kyleservicetech/BattIR-meter/Photo#5.JPG

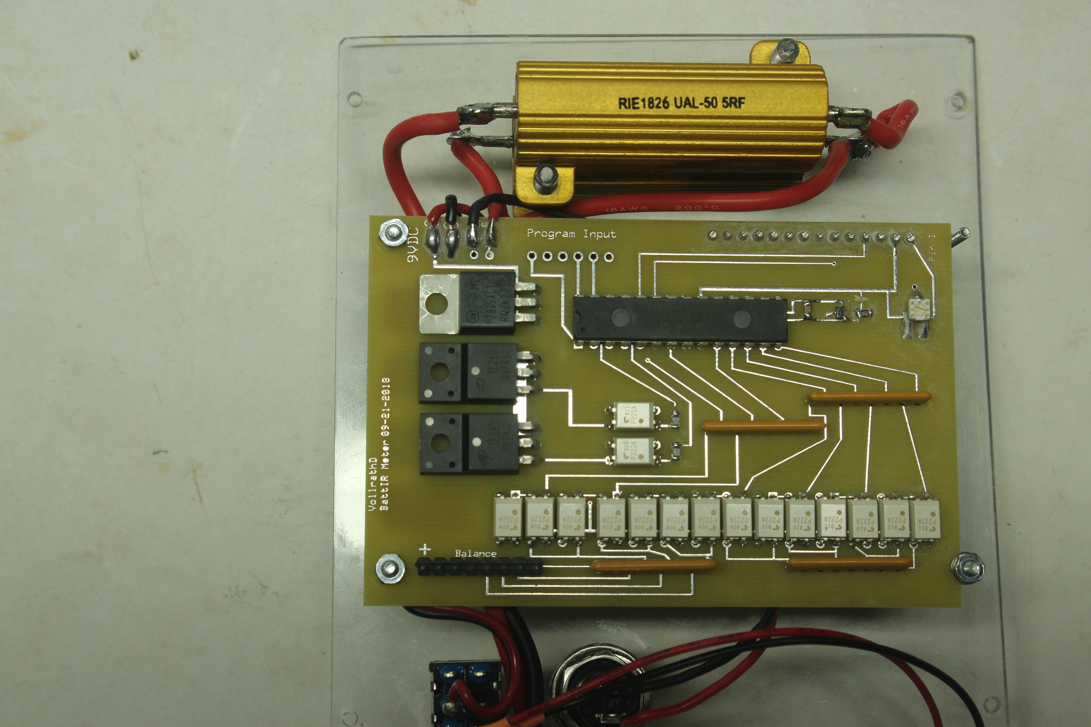
Photo#5.JPG
