kyleservicetech/BattIR-meter/Photo#1.JPG

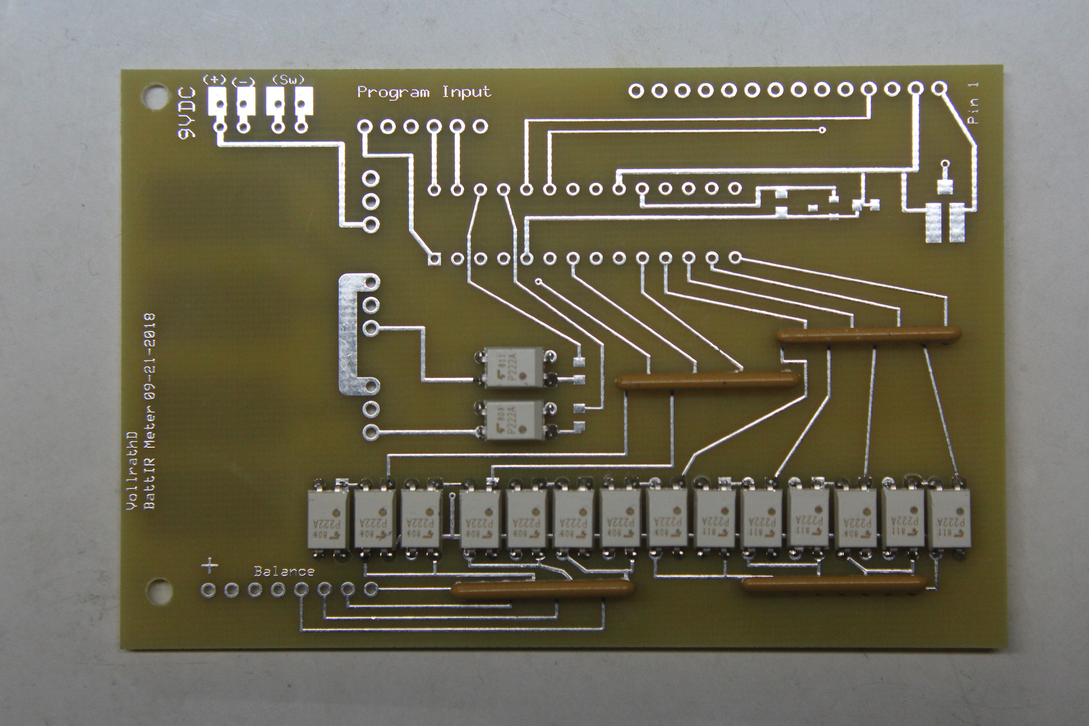
Photo#1.JPG
