kyleservicetech/BattIR-meter/README.md

# BattIR-meter
This project design allows measuring the internal resistance of each cell in a LiPo, Life, or A123 battery pack.

The parts can be ordered from Digikey.com with the following link

http://www.digikey.com/short/p3c1f5
