kyleservicetech/BattIR-meter/BattIR Meter Project PDF File.pdf

## The BattIR Project with USB connection to IBM PC

Since the author has no control over the quality or skill level of the persons building up this project, there needs to be the following disclaimer.

The software is provided “As Is” with the author not being responsible for any claim, damages or similar issues on the use of this project.

An added feature is the addition of BattIR software to allow downloading all test results through an Arduino Nano’s USB port directly to an IBM PC through its USB port, using a standard USB cable. The Arduino Nano plugs into the existing BattIR microcontroller programming pins, no PCB change required.

HOW IT WORKS

The BattIR project uses 14 electronic relays to connect each battery cell in succession to the same Pic-Chip A/D input. This way there is no variation in the PicChip between different A/D inputs since only one PicChip channel is used.

So far, 41 BattIR meters have been built, all work very well. (I did miss a solder joint on one meter)

A precision 0.2% Voltage reference, part U2 has been added to the original design in order to improve basic DC voltage accuracy, as compared to the original BattIR meters.

In addition, each cell voltage is read 10 times, and an average is taken of those voltage readings. .

The multiple cell voltage readings eliminates voltage "jitter" on the last digit of the four digit display of the battery voltage. Tests on the three prototypes shows that the voltage read out is accurate to around 0.3% on voltages between 2.5 VDC and 4.5 VDC as compared to my Fluke 87V meter while using its Hi Res feature. These units should hold plus/ minus 1% on the measured cell voltages.

The BattIR meter first connects a 5 Ohm 1% resistor across the battery pack, then reads and saves the individual cell voltage readings to the first table. Next, it connects a 2.00 Ohm 1% resistor to the battery pack, and reads and saves the individual voltage readings to a second table.

Last, the BattIR meter applies both the 5.00 and 2.00 Ohm resistors in parallel to the battery pack, and again reads and saves the voltage readings to a third table.

The individual cell IR calculation is:

IR = (Volts Low Amps- Volts Hi Amps)

Divided by (High Amps - Low Amps)

The first and third voltage readings are used to calculate the individual cell IR values and displays them to the LCD display.

Example, a cell measuring 3.71 Volts at 4.45 Amps and measuring 3.58 Volts at 15.1 Amps would have a cell resistance of 12.2 MilliOhms. This meter has a maximum of 999 MilliOhms range.

The software also has commands to preset the batteries Mah rating and uses the Mah rating to calculate the maximum safe current for the battery.

Credit must be given to Forsyth, Julian, and Giles for their work in testing countless LiPo batteries, and coming up with the formula that is used to calculate the maximum safe current for the given LiPo or LiFe/ A123 battery pack. These names are included on the BattIR LCD display.

Last but not least, the test currents that are applied to the battery pack are derived by the batteries voltage divided by the resistance of the power resistors.

If the 1% 5 ohm and 2 ohm power resistors are not available, 5% units can be substituted with a slight loss of IR accuracy.

One feature of this setup is that the 5, 6 or 7 cell packs will pull higher test currents through the power resistors, compared to much lower test currents that occur with the 1, 2 or 3 cell LiPo packs.

As a result, those usually smaller 2 cell 200 Mah battery packs are tested at current levels of around 5 Amps, compared to the test current of around 15 Amps for the higher voltage big battery packs.

This meter also has the capability of displaying the individual cell voltage of the battery pack on each of the load currents applied to the pack. It can also display all cell voltages while connected to an ESC and motor under full power as an example.

## Time to start the project!

(Equipment Needed)

This project uses a number of surface mounted resistors in its design. Surface mounted resistors might be a bit scary for someone that has not worked with them. But, with a bit of practice, assembly of a project like this goes much faster than through hole resistors.

Note the required equipment in the photo at right that will be used to build up the circuit board. An old cookie sheet will aid in finding
any | surface | mounted | parts | accidentally
dropped. For older folks, a magnifying visor helps a lot. Then a needle pointed soldering iron is used along with tweezers to place and solder the components. I use 0.040 sized rosin cored solder for these type projects.

What I’ve learned over the years, is to place a

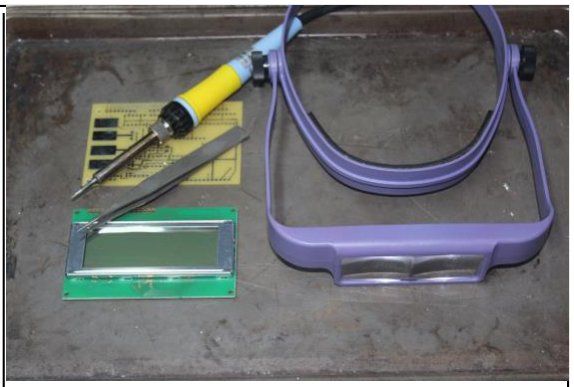
[picture p3: figure]

tiny bit of solder on ONE of the pads of the resistor as an example.

Then, place the iron on that bit of solder, and, using the tweezers, “slide” the surface mounted resistor into that tiny bit of solder. Wait for the solder to cool off, then solder the other end of the resistor. This takes longer to describe than actually doing it.

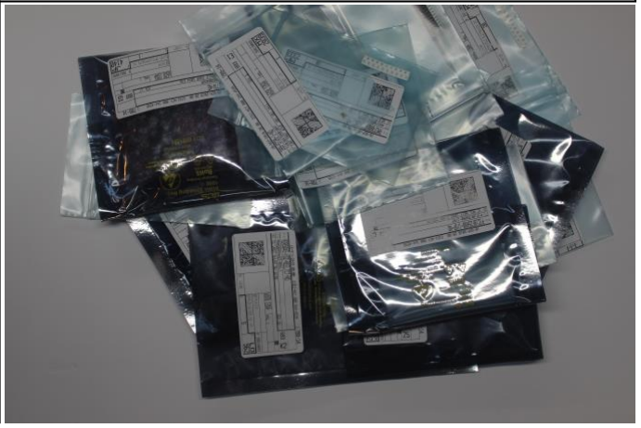
[picture p4: figure]
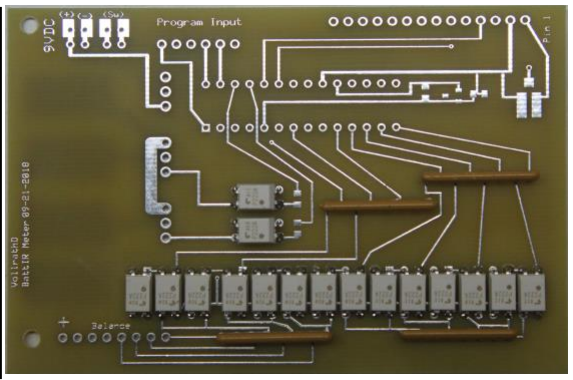
[picture p5: figure]

## Install the electronic relays

Next, insert each of the 16 electronic relays into the circuit board. Be careful to not have any of the relay pins bent under the relay, rather than going into their respective holes. Also, pay attention to the small dot on these relays showing which is pin #1. Next, install and solder up the resistor networks that are used with the electronic relays.

At the right is the components as received from www.digikey.com. All components are placed in individual bags, properly marked with component type and value.

Order extra resistors and capacitors. Most 10 parts for under 50 cents.

These correspond with the parts list
that | is | part | of | the
www.expresspcb.com schematic that is included along with the PCB layout that can be downloaded from github.

## Install The Microcontroller

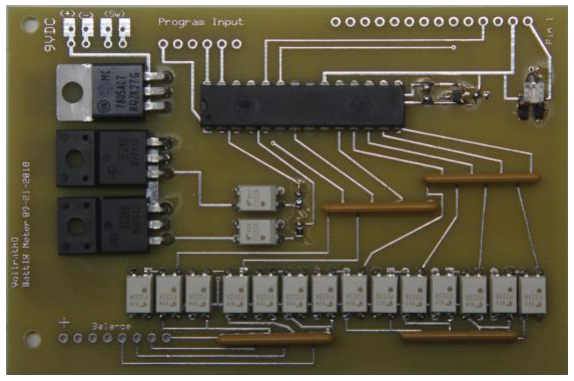
[picture p6: figure]

Here we install the microcontroller, along with the 5 Volt regulator that powers the project, along with the two MosFets that are used to connect the battery under test to the load resistors.

Be very careful not to fold any of the microcontroller pins under the chip. If this happens it will be difficult to fix after the chip is soldered. Again, be aware of the location of the dot on the microcontroller, it should be located to the bottom left on the photo. (The PCB Pin#1 hole is square, the remaining pin holes are round.)

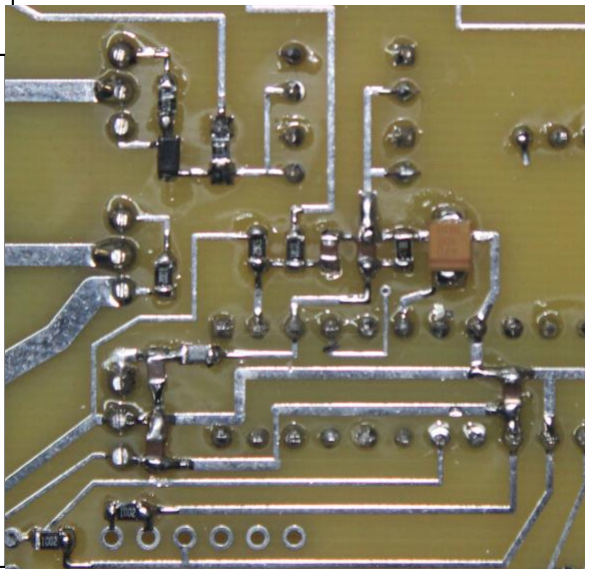
[picture p7: figure]

## Install the surface mounted parts on the back of the PCB

Time to install the parts on the back of the PCB, paying particular attention to the part number, part value, and location on the PCB.

For those interested in this project, the author will make available a limited supply of the circuit board plus the programmed microcontroller for 20% over cost of the two items, plus shipping cost, USA only.

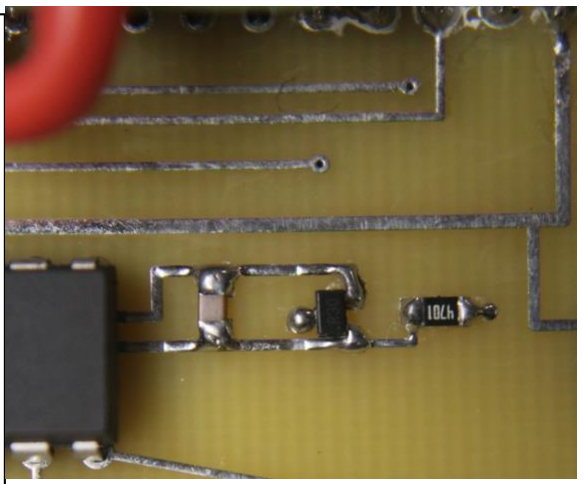
[picture p8: figure]

## Install the 0.2% voltage reference

with its associated resistor and capacitor. Next, install the potentiometer that is used to set the LCD display Contrast.

Note the very tiny size of this voltage reference. Here is the time where it would be wise to do the assembly of the BattIR PCB on top of an old cookie sheet or similar in case the reference chip is dropped.

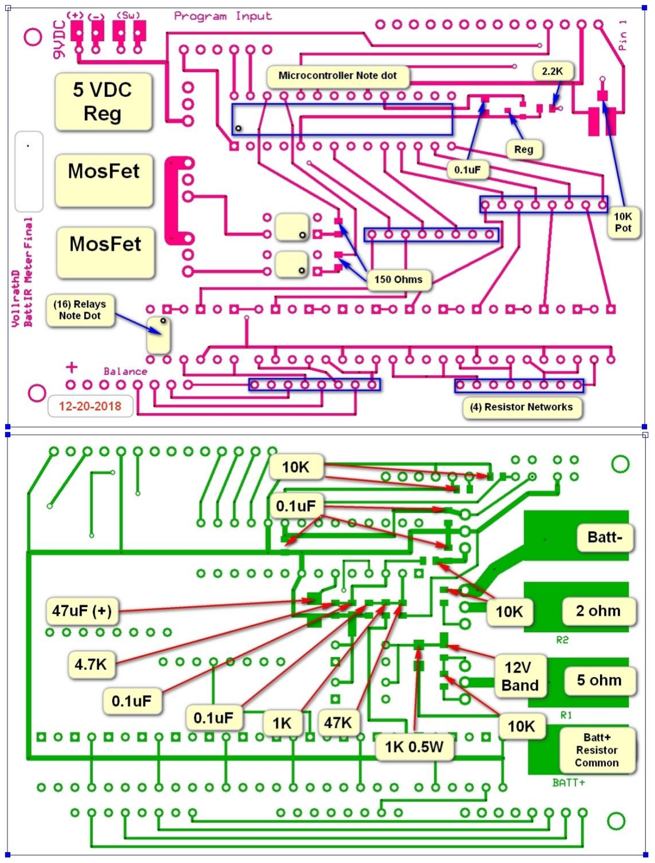
[picture p9: page 4]

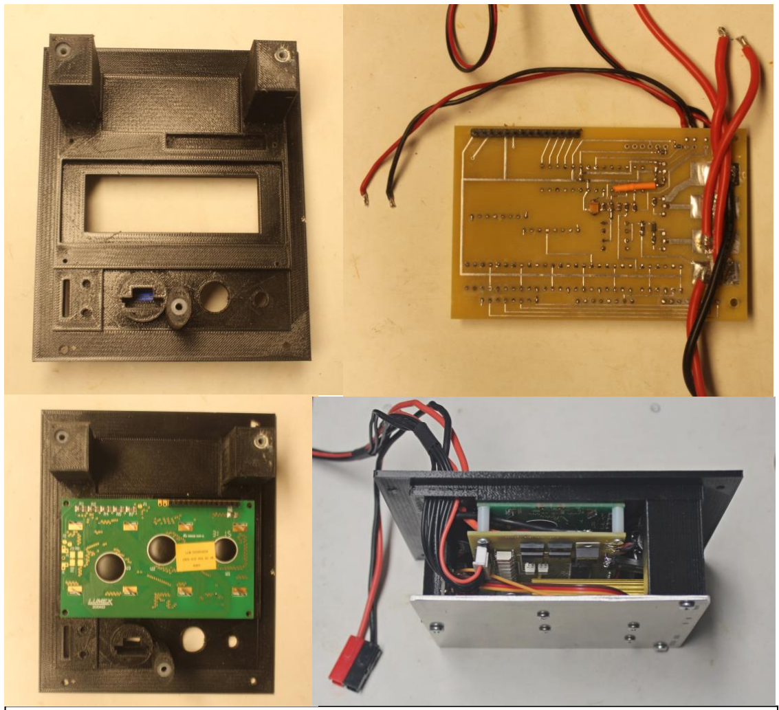
[picture p10: figure]

The final project as installed on a 3D Printed panel. The PCB is mounted along with the LCD with some #3 screws drilled into the 3D cutout for the display.

Underneath the PCB are the wire connections to the two power resistors. Since the 3D PLA filament doesn’t work well with heat from those power resistors, the resistors were mounted to an aluminum sheet. Thick CA is very effective in gluing items to the 3D printed panels. Also shown is the Arduino Nano that provides the interface between the BattIR meter and the IBM PC computer USB port.

When first powered up, the LCD display will be blank. The top right potentiometer must be turned counter clockwise until the LCD display properly displays the information.

The TinkerCad 3D drawing files show this version of the front panel along with the ventilated case shown on the next page. Larger ventilation slots were provided to lower the risk of heat from the power resistors from affecting the PLA filament used to build the 3D enclosures.

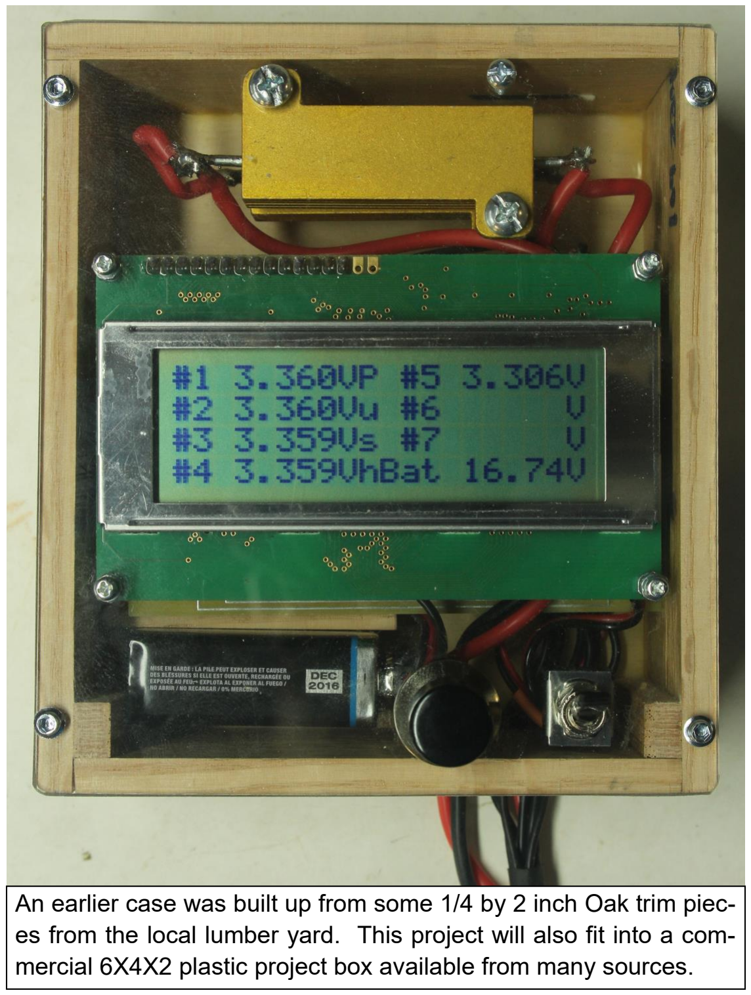
[picture p11: page 6]

## An earlier case was built up from some 1/4 by 2 inch Oak trim pieces from the local lumber yard. This project will also fit into a com-

mercial 6X4X2 plastic project box available from many sources.

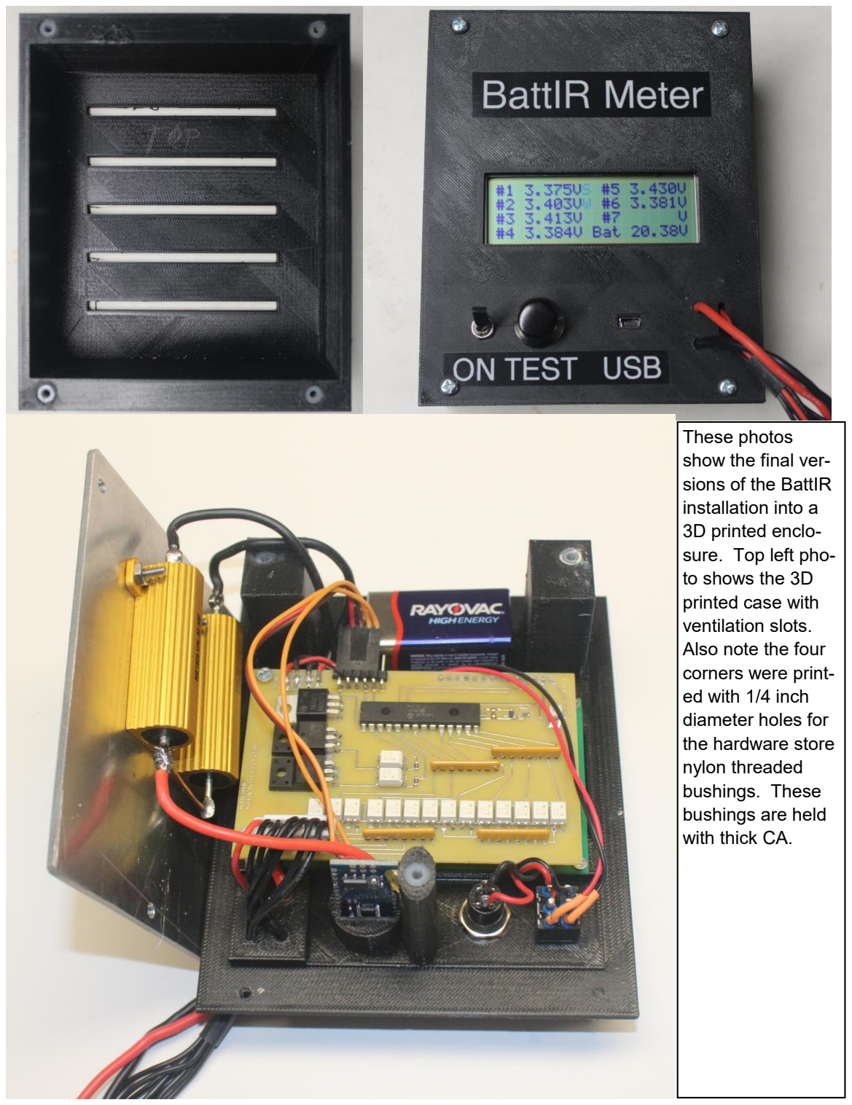
[picture p12: page 7]

These photos
show the final versions of the BattIR
installation into a
3D printed enclosure. Top left photo shows the 3D
printed case with
ventilation slots.
Also note the four
corners were printed with 1/4 inch
diameter holes for
the hardware store
nylon threaded
bushings. These
bushings are held
with thick CA.
