kyleservicetech/BattIR-meter/Gerber Text.jpg

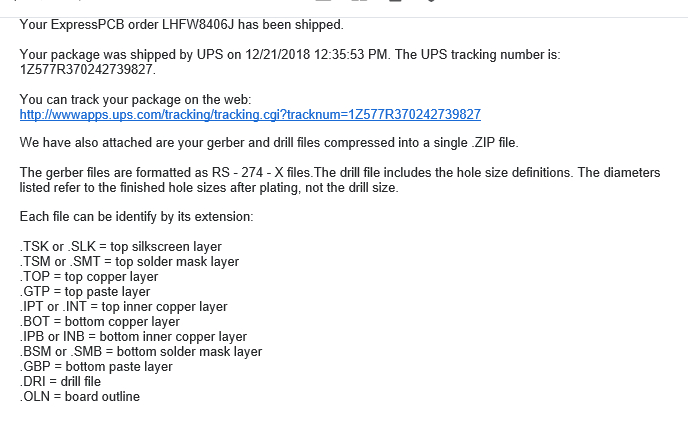
Gerber Text.jpg
