kyleservicetech/BattIR-meter/Interconnection SchematicVrI.jpg

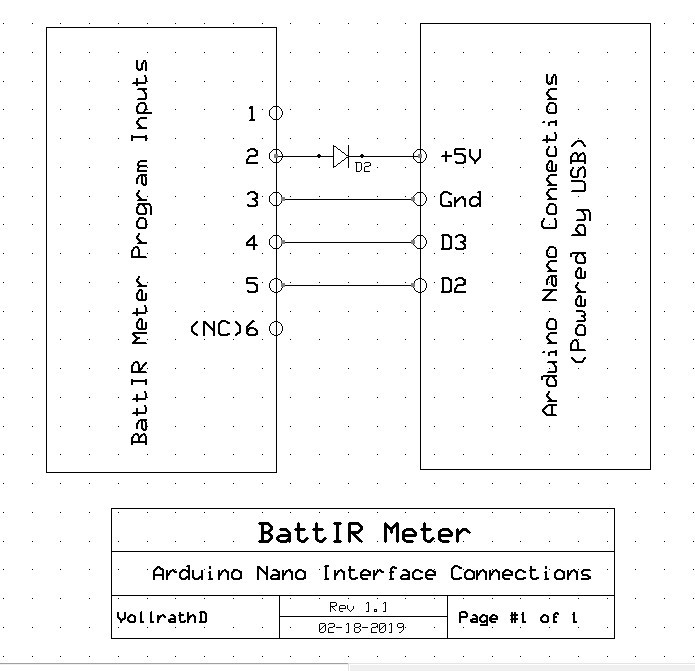
Interconnection SchematicVrI.jpg
