kyleservicetech/BattIR-meter/Photo#2.JPG

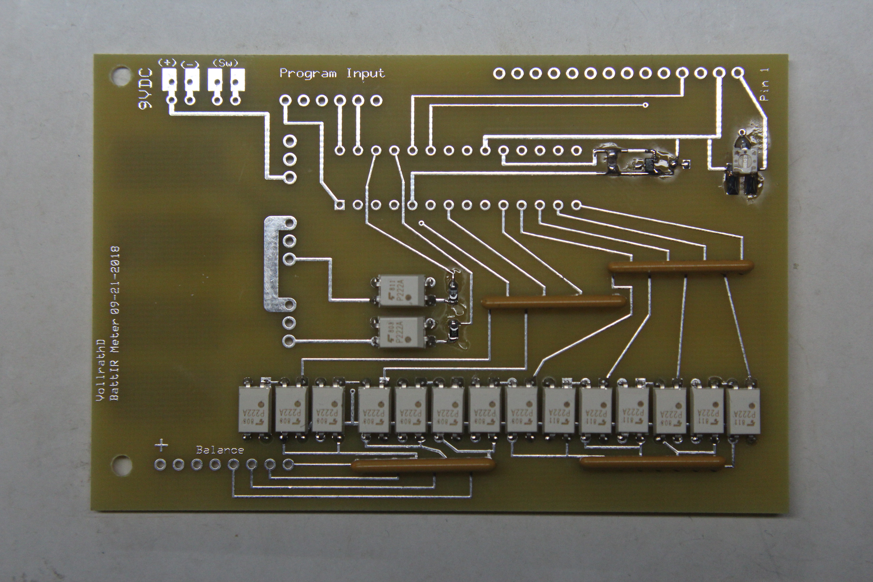
Photo#2.JPG
