kyleservicetech/BattIR-meter/Photo#3.JPG

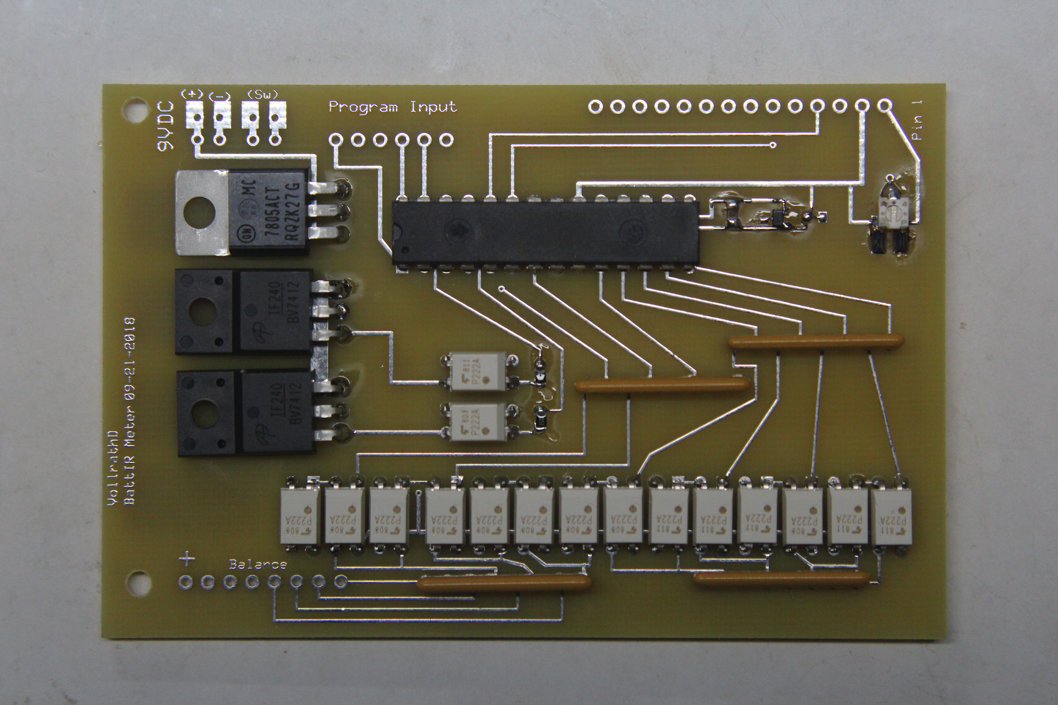
Photo#3.JPG
