kyleservicetech/BattIR-meter/Photo#4.JPG

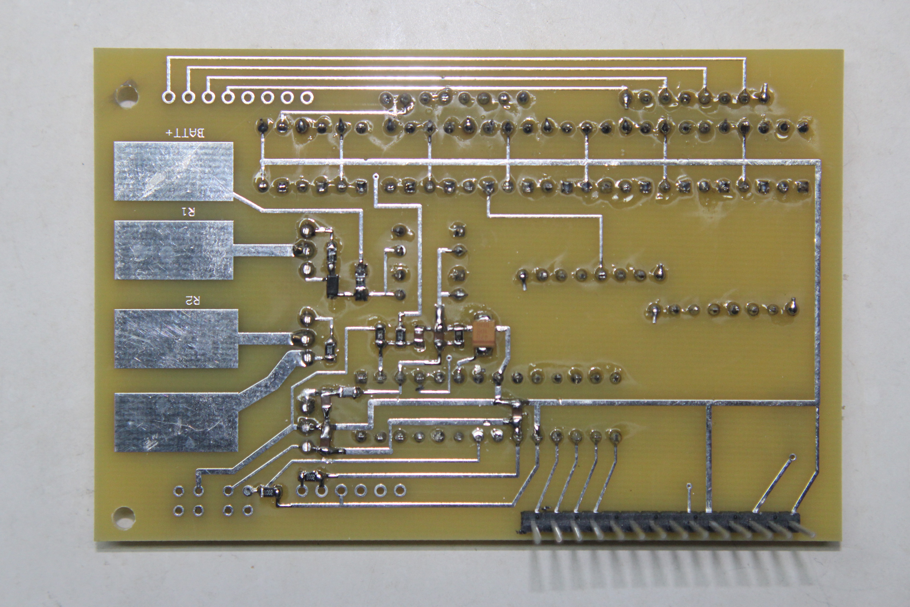
Photo#4.JPG
