kyleservicetech/BattIR-meter/Photo#6.JPG

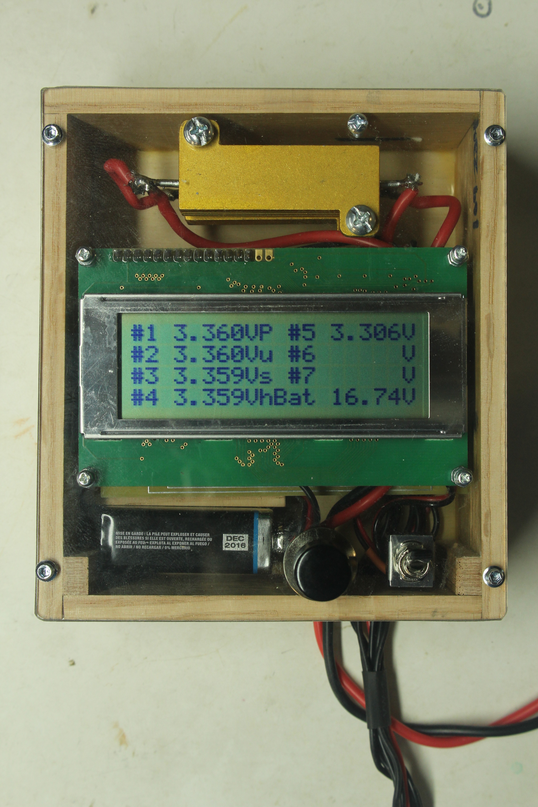
Photo#6.JPG
