kyleservicetech/BattIR-meter/BattIR Case Final 05_03_2019.stl

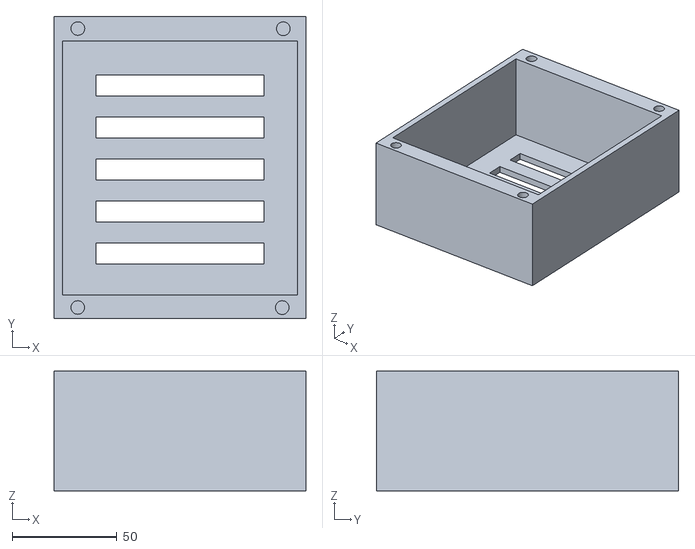
[picture p19: CAD file, 2019-05-03]
BattIR Case Final 05_03_2019.stl
120.0 x 144.0 x 57.0
