kyleservicetech/BattIR-meter/BattIR Lid Final 05_03_2019.stl

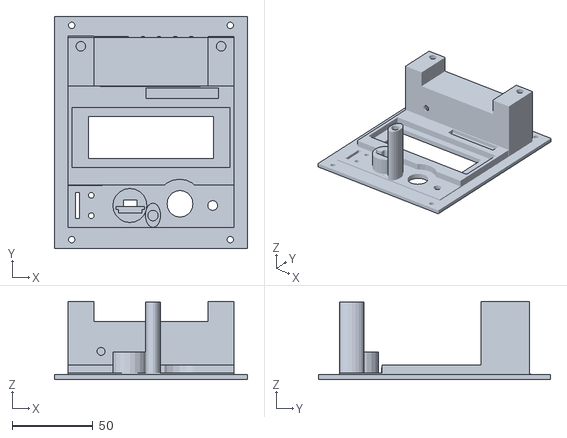
[picture p20: CAD file, 2019-05-03]
BattIR Lid Final 05_03_2019.stl
120.0 x 144.0 x 48.5
