kyleservicetech/BattIR-meter/BattUSB Panel Final1.stl

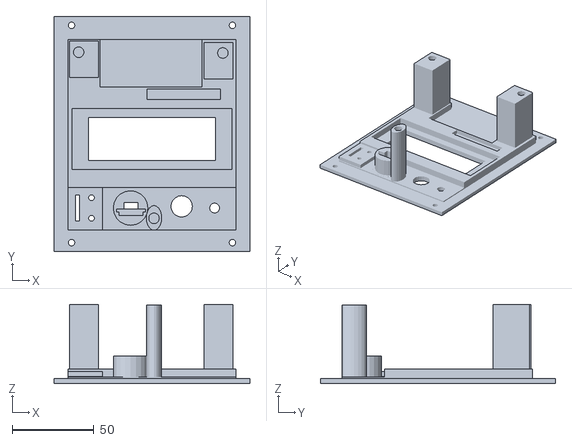
[picture p21: CAD file, 2019-01-27]
BattUSB Panel Final1.stl
120.0 x 144.0 x 48.5
