kyleservicetech/BattIR-meter/(list of files, cad)

Other CAD files:
BattIR Case Final.stl
