kyleservicetech/BattIR-meter/(list of files, drawings)

Other design files:
BatteryIR Meter PCB with resistors 330 Ohm Dip And Nih Test inline dips Plus 5VDC Final.pcb
