kyleservicetech/BattIR-meter/(commit log)

2018-10-03 Add files via upload
    Photos of the circuit board during assembly, along with the finished project.
2019-02-19 Add files via upload
    Note: The data and strobe connections were moved to D2 and D3 to accommodate the Arduino Nano fitting into the 3D panel.
